RohanMuthyala47/FPGA_Image_Haze_Removal/Vivado/RTL/sim/building_512.bmp

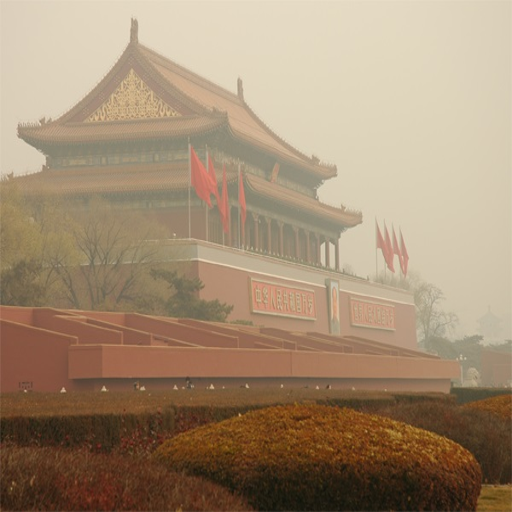
Vivado/RTL/sim/building_512.bmp
