RohanMuthyala47/FPGA_Image_Haze_Removal/Vivado/RTL/sim/road_512.bmp

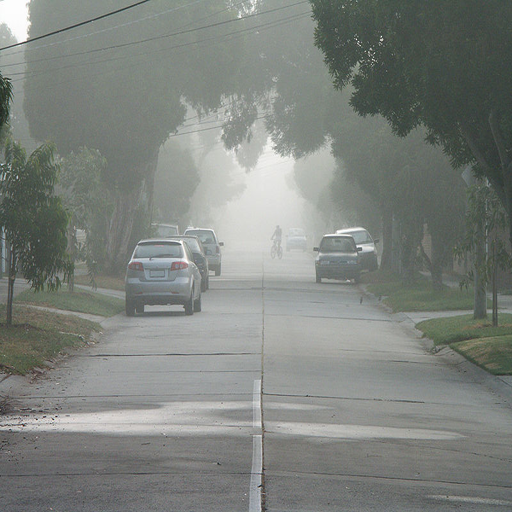
Vivado/RTL/sim/road_512.bmp
