RohanMuthyala47/FPGA_Image_Haze_Removal/Vivado/RTL/sim/town_512.bmp

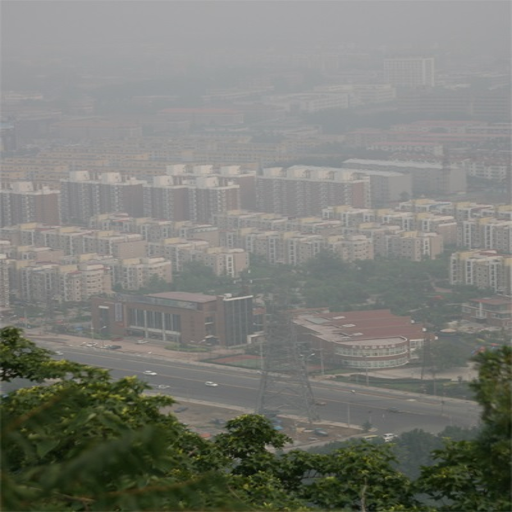
Vivado/RTL/sim/town_512.bmp
