RohanMuthyala47/FPGA_Image_Haze_Removal/Vivado/RTL/sources/TE_and_SRSC.v

// Transmission Estimation, Scene Recovery and Saturation Correction Module
`define Image_Size (512 * 512)
module TE_and_SRSC (
    input        clk,
    
    input        input_valid,                                 // Input data valid signal
    input [23:0] input_pixel_1, input_pixel_2, input_pixel_3,
                 input_pixel_4, input_pixel_5, input_pixel_6,
                 input_pixel_7, input_pixel_8, input_pixel_9, // 3x3 window input
    
    input [7:0]  A_R, A_G, A_B,                               // Atmospheric Light Values
    input [9:0]  Inv_AR, Inv_AG, Inv_AB,                      // Inverse Atmospheric Light Values(Q0.10)

    output [7:0] J_R, J_G, J_B,                               // Output corrected pixels
    output       output_valid                                 // Output data valid signal
);

    // Pipeline the Center Pixel for SRSC
    reg [23:0] I_P, I_P1, I_P2, I_P3, I_P4;
    
    // Pipeline Atmospheric Light values for SRSC
    reg [7:0]  A_R_P, A_G_P, A_B_P;
    reg [7:0]  A_R_P1, A_G_P1, A_B_P1;
    reg [7:0]  A_R_P2, A_G_P2, A_B_P2;
    reg [7:0]  A_R_P3, A_G_P3, A_B_P3;
    reg [7:0]  A_R_P4, A_G_P4, A_B_P4;
    
    //==================================================================================
    // STAGE 4 LOGIC
    //==================================================================================
    
    // Detect the type of edge in the 3x3 window
    wire       corner_pixels_weight, edge_pixels_weight, center_pixel_weight;
    
    // Pipeline Registers
    reg        corner_pixels_weight_P, edge_pixels_weight_P, center_pixel_weight_P;
    
    reg [9:0]  Inv_AR_P, Inv_AG_P, Inv_AB_P;
    
    reg [23:0] I1_P, I2_P, I3_P,
               I4_P, I5_P, I6_P,
               I7_P, I8_P, I9_P;
               
    reg        stage_4_valid;
    
    //===========================================
    // Detect the type of edge in the 3x3 window
    FilterWeights_Estimation_Top Estimate_FilterWeights (
        .input_pixel_1(input_pixel_1), .input_pixel_2(input_pixel_2), .input_pixel_3(input_pixel_3),
        .input_pixel_4(input_pixel_4),                                .input_pixel_6(input_pixel_6), 
        .input_pixel_7(input_pixel_7), .input_pixel_8(input_pixel_8), .input_pixel_9(input_pixel_9),
        
        .corner_pixels_weight(corner_pixels_weight),
        .edge_pixels_weight(edge_pixels_weight),
        .center_pixel_weight(center_pixel_weight)
    );
    //===========================================
    
    // Update Stage 4 Pipeline Registers
    always @(posedge clk) begin
        corner_pixels_weight_P <= corner_pixels_weight;
        edge_pixels_weight_P   <= edge_pixels_weight;
        center_pixel_weight_P  <= center_pixel_weight;
        
        I1_P <= input_pixel_1; I2_P <= input_pixel_2; I3_P <= input_pixel_3;
        I4_P <= input_pixel_4; I5_P <= input_pixel_5; I6_P <= input_pixel_6;
        I7_P <= input_pixel_7; I8_P <= input_pixel_8; I9_P <= input_pixel_9;
                    
        Inv_AR_P <= Inv_AR; Inv_AG_P <= Inv_AG; Inv_AB_P <= Inv_AB;

        I_P <= input_pixel_5;
        
        A_R_P <= A_R;
        A_G_P <= A_G;
        A_B_P <= A_B;
                    
        stage_4_valid <= input_valid;
    end
    
    //==================================================================================
    // STAGE 5 LOGIC
    //==================================================================================
    
    wire [7:0] filtered_pixel_red, filtered_pixel_green, filtered_pixel_blue;
    
    // Pipeline Registers
    reg [9:0]  Inv_AR_P1, Inv_AG_P1, Inv_AB_P1;
    
    reg [7:0]  filtered_pixel_red_P, filtered_pixel_green_P, filtered_pixel_blue_P;
    
    reg        stage_5_valid;
    
    //===========================================
    // Filter blocks to apply Gaussian Filter or Mean Filter based on the edge detected
    WindowFilter Red_WindowFilter (
        .w_corner(corner_pixels_weight_P),
        .w_edge(edge_pixels_weight_P),
        .w_center(center_pixel_weight_P),
    
        .input_pixel_1(I1_P[23:16]), .input_pixel_2(I2_P[23:16]), .input_pixel_3(I3_P[23:16]),
        .input_pixel_4(I4_P[23:16]), .input_pixel_5(I5_P[23:16]), .input_pixel_6(I6_P[23:16]),
        .input_pixel_7(I7_P[23:16]), .input_pixel_8(I8_P[23:16]), .input_pixel_9(I9_P[23:16]),
        
        .filtered_pixel(filtered_pixel_red)
    );
                   
    WindowFilter Green_WindowFilter (
        .w_corner(corner_pixels_weight_P),
        .w_edge(edge_pixels_weight_P),
        .w_center(center_pixel_weight_P),

        .input_pixel_1(I1_P[15:8]), .input_pixel_2(I2_P[15:8]), .input_pixel_3(I3_P[15:8]),
        .input_pixel_4(I4_P[15:8]), .input_pixel_5(I5_P[15:8]), .input_pixel_6(I6_P[15:8]),
        .input_pixel_7(I7_P[15:8]), .input_pixel_8(I8_P[15:8]), .input_pixel_9(I9_P[15:8]),
        
        .filtered_pixel(filtered_pixel_green)
    );
                   
    WindowFilter Blue_WindowFilter (
        .w_corner(corner_pixels_weight_P),
        .w_edge(edge_pixels_weight_P),
        .w_center(center_pixel_weight_P),

        .input_pixel_1(I1_P[7:0]), .input_pixel_2(I2_P[7:0]), .input_pixel_3(I3_P[7:0]),
        .input_pixel_4(I4_P[7:0]), .input_pixel_5(I5_P[7:0]), .input_pixel_6(I6_P[7:0]),
        .input_pixel_7(I7_P[7:0]), .input_pixel_8(I8_P[7:0]), .input_pixel_9(I9_P[7:0]),
                       
        .filtered_pixel(filtered_pixel_blue)
    );
    //===========================================
    
    // Update Stage 5 Pipeline Registers 
    always @(posedge clk) begin
        Inv_AR_P1 <= Inv_AR_P;
        Inv_AG_P1 <= Inv_AG_P;
        Inv_AB_P1 <= Inv_AB_P;
            
        filtered_pixel_red_P   <= filtered_pixel_red;
        filtered_pixel_green_P <= filtered_pixel_green;
        filtered_pixel_blue_P  <= filtered_pixel_blue;
                                
        I_P1 <= I_P;
                                
        A_R_P1 <= A_R_P;
        A_G_P1 <= A_G_P; 
        A_B_P1 <= A_B_P;
                                
        stage_5_valid <= stage_4_valid;
    end
    
    //==========================================================================
    // STAGE 6 LOGIC
    //==========================================================================
    
    // Select signal for minimum filter result
    wire [1:0] min_val_sel;
    
    wire [7:0] min_Fc;
    
    wire [9:0] min_Ac;
        
    wire [9:0] product;
        
    // (Ic - Ac) Result
    wire [7:0] IR_minus_AR, IG_minus_AG, IB_minus_AB;
    wire       add_or_sub_R, add_or_sub_G, add_or_sub_B;
    
    wire [7:0] I_R = I_P1[23:16], I_G = I_P1[15:8], I_B = I_P1[7:0];
        
    // Pipeline Registers for stage 6
    reg  [7:0] IR_minus_AR_P, IG_minus_AG_P, IB_minus_AB_P;
    reg        add_or_sub_R_P, add_or_sub_G_P, add_or_sub_B_P;
    
    reg        stage_6_valid;
    
    //===========================================
    // Comparator to determine the minimum value of the filter results
    Comparator_Minimum Minimum_Filter_Select (
        .red(filtered_pixel_red_P), .green(filtered_pixel_green_P), .blue(filtered_pixel_blue_P),
        
        .min_val_sel(min_val_sel)
    );
    
    // Multiplexer to choose minimum of the filter results
    Fc_Multiplexer Minimum_Filtered_Pixel_Value (
        .F_R(filtered_pixel_red_P), .F_G(filtered_pixel_green_P), .F_B(filtered_pixel_blue_P),
        
        .sel(min_val_sel),
        
        .Fc(min_Fc)
    );
    
    // Multiplexer to choose minimum of Atmospheric Light values
    Inv_Ac_Multiplexer Minimum_Inv_ALE_Value (
        .Inv_AR(Inv_AR_P1), .Inv_AG(Inv_AG_P1), .Inv_AB(Inv_AB_P1),
        
        .sel(min_val_sel),
        
        .Inv_Ac(min_Ac)
    );
    
    // Multiplier modules to compute Fc * Ac (Scaled)
    Multiplier_TE Multiplier_TE (
        .clk(clk),
        
        .Fc(min_Fc), .Inv_Ac(min_Ac),
        
        .product(product)
    );
    
    // SUBTRACTOR MODULES TO COMPUTE (|Ic - Ac|)
    Subtractor_SRSC Sub_Red (
        .Ic(I_R),
        .Ac(A_R_P1),
            
        .Ic_minus_Ac(IR_minus_AR),
            
        .add_or_sub(add_or_sub_R)
    );
                    
    Subtractor_SRSC Sub_Green (
        .Ic(I_G),
        .Ac(A_G_P1),
            
        .Ic_minus_Ac(IG_minus_AG),
            
        .add_or_sub(add_or_sub_G)
    );
                
    Subtractor_SRSC Sub_Blue (
        .Ic(I_B),
        .Ac(A_B_P1),
            
        .Ic_minus_Ac(IB_minus_AB),
            
        .add_or_sub(add_or_sub_B)
    );
    //===========================================
    
    // Update Stage 6 Pipeline Registers
    always @(posedge clk) begin
        I_P2 <= I_P1;
            
        A_R_P2 <= A_R_P1;
        A_G_P2 <= A_G_P1;
        A_B_P2 <= A_B_P1;
                        
        IR_minus_AR_P <= IR_minus_AR;
        IG_minus_AG_P <= IG_minus_AG;
        IB_minus_AB_P <= IB_minus_AB;
                       
        add_or_sub_R_P <= add_or_sub_R;
        add_or_sub_G_P <= add_or_sub_G;
        add_or_sub_B_P <= add_or_sub_B;
            
        stage_6_valid <= stage_5_valid;
    end
    
    //==========================================================================
    // STAGE 7 LOGIC
    //==========================================================================
    
    wire [7:0] transmission_reciprocal;
    
    // (|Ic-Ac|)*(1/T) Result
    wire [7:0] IR_minus_AR_x_T, IG_minus_AG_x_T, IB_minus_AB_x_T;
    
    // Pipeline Registers for stage 7
    reg        add_or_sub_R_P1, add_or_sub_G_P1, add_or_sub_B_P1;
    
    reg        stage_7_valid;
    
    //===========================================
    // TRANSMISSION RECIPROCAL LOOKUP TABLE
    Transmission_Reciprocal_LUT Transmission_Reciprocal_LUT (
        .in(product),
                            
        .out(transmission_reciprocal)
    );
                    
    // MULTIPLIER MODULES TO COMPUTE (|Ic-Ac|)*(1/T)
    Multiplier_SRSC Multiplier_SRSC_Red (
        .clk(clk), 
            
        .Inv_Trans(transmission_reciprocal), 
        .Ic_minus_Ac(IR_minus_AR_P), 
            
        .product(IR_minus_AR_x_T) 
    );
                            
    Multiplier_SRSC Multiplier_SRSC_Green (
        .clk(clk), 
             
        .Inv_Trans(transmission_reciprocal), 
        .Ic_minus_Ac(IG_minus_AG_P), 
            
        .product(IG_minus_AG_x_T) 
    ); 
                        
    Multiplier_SRSC Multiplier_SRSC_Blue (
        .clk(clk), 
            
        .Inv_Trans(transmission_reciprocal), 
        .Ic_minus_Ac(IB_minus_AB_P), 
            
        .product(IB_minus_AB_x_T) 
    );
    //===========================================
        
    // Update stage 7 pipeline registers
    always @(posedge clk) begin
        I_P3 <= I_P2;
      
        A_R_P3 <= A_R_P2;
        A_G_P3 <= A_G_P2;
        A_B_P3 <= A_B_P2;

        add_or_sub_R_P1 <= add_or_sub_R_P;
        add_or_sub_G_P1 <= add_or_sub_G_P;
        add_or_sub_B_P1 <= add_or_sub_B_P;
            
        stage_7_valid <= stage_6_valid;
    end

    //==========================================================================
    // STAGE 8 LOGIC
    //==========================================================================
    
    // Pipeline Registers for stage 8
    reg       add_or_sub_R_P2, add_or_sub_G_P2, add_or_sub_B_P2;
    
    reg       stage_8_valid;
        
    // Update stage 8 pipeline registers
    always @(posedge clk) begin
        A_R_P4 <= A_R_P3;
        A_G_P4 <= A_G_P3;
        A_B_P4 <= A_B_P3;
        
        I_P4 <= I_P3;
        
        add_or_sub_R_P2 <= add_or_sub_R_P1;
        add_or_sub_G_P2 <= add_or_sub_G_P1;
        add_or_sub_B_P2 <= add_or_sub_B_P1;
                
        stage_8_valid <= stage_7_valid;
    end
        
    //==========================================================================
    // STAGE 9 LOGIC
    //==========================================================================
        
    // Compute Ac +/- (|Ic-Ac|/T)
    wire [7:0] Sum_Red, Sum_Green, Sum_Blue;
        
    // Outputs of Look-Up Tables for Saturation Corection
    wire [9:0] J_R_Corrected, J_G_Corrected, J_B_Corrected;
    wire [9:0] A_R_Corrected, A_G_Corrected, A_B_Corrected;
    
    // Pipeline Registers for stage 9
    reg        stage_9_valid;
        
    //===========================================
    // ADDER BLOCKS TO COMPUTE Ac +/- (|Ic-Ac|/T)
    Adder_SRSC Add_Red (
        .Ac(A_R_P4), 
        .Ic(I_P4[23:16]), 
        .Multiplier_out(IR_minus_AR_x_T), 
             
        .add_or_sub(add_or_sub_R_P2), 
             
        .sum(Sum_Red) 
    );
                             
    Adder_SRSC Add_Green (
        .Ac(A_G_P4), 
        .Ic(I_P4[15:8]), 
        .Multiplier_out(IG_minus_AG_x_T), 
      
        .add_or_sub(add_or_sub_G_P2), 
             
        .sum(Sum_Green) 
    );
                             
    Adder_SRSC Add_Blue (
        .Ac(A_B_P4), 
        .Ic(I_P4[7:0]), 
        .Multiplier_out(IB_minus_AB_x_T), 
      
        .add_or_sub(add_or_sub_B_P2), 
              
        .sum(Sum_Blue) 
    );
        
    // LOOK-UP TABLES TO COMPUTE Ac ^ 0.3 AND Jc ^ 0.7
    LUT_03 A_R_Correction (
        .in(A_R_P4), 
        .out(A_R_Corrected) 
    );
        
    LUT_03 A_G_Correction (
        .in(A_G_P4), 
        .out(A_G_Corrected) 
    );
        
    LUT_03 A_B_Correction (
        .in(A_B_P4), 
        .out(A_B_Corrected) 
    ); 
    
    LUT_07 J_R_Correction (
        .in(Sum_Red), 
        .out(J_R_Corrected) 
    );
        
    LUT_07 J_G_Correction (
        .in(Sum_Green), 
        .out(J_G_Corrected) 
    );
        
    LUT_07 J_B_Correction (
        .in(Sum_Blue), 
        .out(J_B_Corrected) 
    );
    
    // MULTIPLIER MODULES TO COMPUTE Ac^0.3 * Jc^0.7
    Saturation_Correction_Multiplier Saturation_Correction_Red (
        .clk(clk), 
      
        .Ac(A_R_Corrected), .Jc(J_R_Corrected), 
      
        .Corrected_Pixel(J_R) 
    );
    
    Saturation_Correction_Multiplier Saturation_Correction_Green (
        .clk(clk), 
            
        .Ac(A_G_Corrected), .Jc(J_G_Corrected), 
            
        .Corrected_Pixel(J_G) 
    );
    
    Saturation_Correction_Multiplier Saturation_Correction_Blue (
        .clk(clk), 
    
        .Ac(A_B_Corrected), .Jc(J_B_Corrected), 
            
        .Corrected_Pixel(J_B) 
    );
    //===========================================
        
    // Update stage 9 pipeline registers
    always @(posedge clk) begin
        stage_9_valid <= stage_8_valid; 
    end
    
    assign output_valid = stage_9_valid; 

endmodule
