RohanMuthyala47/FPGA_Image_Haze_Removal/Vivado/RTL/sources/ALE_Instantiations/Atmospheric_Light_Reciprocal_LUT.v

module Atmospheric_Light_Reciprocal_LUT (
    input  [7:0] in,
    output reg [9:0] out
);

    always @(*) begin
        casez (in)
            8'd  1: out = 10'd 960;  // 0.9375/1 ≈ 0.93750000
            8'd  2: out = 10'd 480;  // 0.9375/2 ≈ 0.46875000
            8'd  3: out = 10'd 320;  // 0.9375/3 ≈ 0.31250000
            8'd  4: out = 10'd 240;  // 0.9375/4 ≈ 0.23437500
            8'd  5: out = 10'd 192;  // 0.9375/5 ≈ 0.18750000
            8'd  6: out = 10'd 160;  // 0.9375/6 ≈ 0.15625000
            8'd  7: out = 10'd 137;  // 0.9375/7 ≈ 0.13392857
            8'd  8: out = 10'd 120;  // 0.9375/8 ≈ 0.11718750
            8'd  9: out = 10'd 107;  // 0.9375/9 ≈ 0.10416667
            8'd 10: out = 10'd  96;  // 0.9375/10 ≈ 0.09375000
            8'd 11: out = 10'd  87;  // 0.9375/11 ≈ 0.08522727
            8'd 12: out = 10'd  80;  // 0.9375/12 ≈ 0.07812500
            8'd 13: out = 10'd  74;  // 0.9375/13 ≈ 0.07211538
            8'd 14: out = 10'd  69;  // 0.9375/14 ≈ 0.06696429
            8'd 15: out = 10'd  64;  // 0.9375/15 ≈ 0.06250000
            8'd 16: out = 10'd  60;  // 0.9375/16 ≈ 0.05859375
            8'd 17: out = 10'd  56;  // 0.9375/17 ≈ 0.05514706
            8'd 18: out = 10'd  53;  // 0.9375/18 ≈ 0.05208333
            8'd 19: out = 10'd  51;  // 0.9375/19 ≈ 0.04934211
            8'd 20: out = 10'd  48;  // 0.9375/20 ≈ 0.04687500
            8'd 21: out = 10'd  46;  // 0.9375/21 ≈ 0.04464286
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
            8'd253: out = 10'd   4;  // 0.9375/253 ≈ 0.00370553
            8'd254: out = 10'd   4;  // 0.9375/254 ≈ 0.00369094
            8'd255: out = 10'd   4;  // 0.9375/255 ≈ 0.00367647
            default: out = 10'd1023; // default case
        endcase
    end

endmodule
