RohanMuthyala47/FPGA_Image_Haze_Removal/Vivado/RTL/sources/SRSC_Instantiations/SaturationCorrection_LUT.v

// LUT for x^0.3 in Q3.7 format
module LUT_03 (
    input      [7:0] in, // Q8.0 input
    output reg [9:0] out // Q3.7 output
);

    always @(*) begin
        casez (in)
            8'd0  : out = 10'd0;  // 0^0.30 ~= 0.000000
            8'd1  : out = 10'd128;  // 1^0.30 ~= 1.000000
            8'd2  : out = 10'd158;  // 2^0.30 ~= 1.231144
            8'd3  : out = 10'd178;  // 3^0.30 ~= 1.390389
            8'd4  : out = 10'd194;  // 4^0.30 ~= 1.515717
            8'd5  : out = 10'd207;  // 5^0.30 ~= 1.620657
            8'd6  : out = 10'd219;  // 6^0.30 ~= 1.711770
            8'd7  : out = 10'd229;  // 7^0.30 ~= 1.792790
            8'd8  : out = 10'd239;  // 8^0.30 ~= 1.866066
            8'd9  : out = 10'd247;  // 9^0.30 ~= 1.933182
            8'd10 : out = 10'd255;  // 10^0.30 ~= 1.995262
            8'd11 : out = 10'd263;  // 11^0.30 ~= 2.053136
            8'd12 : out = 10'd270;  // 12^0.30 ~= 2.107436
            8'd13 : out = 10'd276;  // 13^0.30 ~= 2.158654
            8'd14 : out = 10'd283;  // 14^0.30 ~= 2.207183
            8'd15 : out = 10'd288;  // 15^0.30 ~= 2.253343
            8'd16 : out = 10'd294;  // 16^0.30 ~= 2.297397
            8'd17 : out = 10'd299;  // 17^0.30 ~= 2.339563
            8'd18 : out = 10'd305;  // 18^0.30 ~= 2.380026
            8'd19 : out = 10'd310;  // 19^0.30 ~= 2.418945
            8'd20 : out = 10'd314;  // 20^0.30 ~= 2.456456
            8'd21 : out = 10'd319;  // 21^0.30 ~= 2.492676
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
            8'd253: out = 10'd770;  // 253^0.70 ~= 48.104352
            8'd254: out = 10'd772;  // 254^0.70 ~= 48.237368
            8'd255: out = 10'd774;  // 255^0.70 ~= 48.370227
            default: out = 10'd0;
        endcase
    end
endmodule
