RohanMuthyala47/FPGA_Image_Haze_Removal/Vivado/RTL/sources/SRSC_Instantiations/Transmission_Reciprocal_LUT.v

module Transmission_Reciprocal_LUT (
    input  [9:0] in,      // Q0.10 transmission value (ranges from 0 to 0.65)
    output reg [7:0] out  // Q2.6 reciprocal
);

    always @(*) begin 
        casez (in) 
            10'd   0: out = 8'h40; 
            10'd   1: out = 8'h40;
            10'd   2: out = 8'h40;
            10'd   3: out = 8'h40;
            10'd   4: out = 8'h40;
            10'd   5: out = 8'h40;
            10'd   6: out = 8'h40;
            10'd   7: out = 8'h40;
            10'd   8: out = 8'h41;
            10'd   9: out = 8'h41;
            10'd  10: out = 8'h41;
            10'd  11: out = 8'h41;
            10'd  12: out = 8'h41;
            10'd  13: out = 8'h41;
            10'd  14: out = 8'h41;
            10'd  15: out = 8'h41;
            10'd  16: out = 8'h41;
            10'd  17: out = 8'h41;
            10'd  18: out = 8'h41;
            10'd  19: out = 8'h41;
            10'd  20: out = 8'h41;
            10'd  21: out = 8'h41;
            10'd  22: out = 8'h41;
            10'd  23: out = 8'h41;
            10'd  24: out = 8'h42;
            10'd  25: out = 8'h42;
            10'd  26: out = 8'h42;
            10'd  27: out = 8'h42;
            10'd  28: out = 8'h42;
            10'd  29: out = 8'h42;
            10'd  30: out = 8'h42;
            10'd  31: out = 8'h42;
            10'd  32: out = 8'h42;
            10'd  33: out = 8'h42;
            10'd  34: out = 8'h42;
            10'd  35: out = 8'h42;
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
            10'd 661: out = 8'hB5;
            10'd 662: out = 8'hB5;
            10'd 663: out = 8'hB6;
            10'd 664: out = 8'hB6;
            10'd 665: out = 8'hB7;
            10'd 666: out = 8'hB7;
            default:  out = 8'hB8;
        endcase
    end
endmodule
