RohanMuthyala47/FPGA_Image_Haze_Removal/Vivado/RTL/sources/TE_Instantiations/Comparator_Minimum.v

// Comparator module which outputs the minimum value of the inputs
module Comparator_Minimum (
    input  [7:0] red, green, blue,
    output [1:0] min_val_sel
);
    
    localparam RED = 2'b00, GREEN = 2'b01, BLUE = 2'b10;
    
    assign min_val_sel = (red <= green && red <= blue)   ? RED : 
                         (green <= red && green <= blue) ? GREEN : 
                                                           BLUE;

endmodule
