RohanMuthyala47/FPGA_Image_Haze_Removal/Vivado/Verilog/sources/TE_Instantiations/Stage_7_Mux.v

// Stage 7 multiplexer to choose the pre-transmission value based on edge detected
module Pre_Transmission_Mux (
    input  [13:0] a, b, c,
    input  [1:0]  sel,
        
    output [13:0] out
);
    
    assign out = (sel == 2'b00) ? a : 
                 (sel == 2'b01) ? b : 
                 (sel == 2'b10) ? c :
                 13'b0;
    
endmodule
