RohanMuthyala47/FPGA_Image_Haze_Removal/Verilog/srcs/TE_Instantiations/Mux_16bit.v

// Stage 7 multiplexer
module mux_16bit(
    input [15:0] a, b, c,
    input [1:0]  sel,
        
    output [15:0] out
);
    
    assign out = (sel == 2'b00) ? a : 
                 (sel == 2'b01) ? b : 
                 (sel == 2'b10) ? c :
                  0;
    
endmodule
