RohanMuthyala47/FPGA_Image_Haze_Removal/(commit log)

2025-07-15 Update and rename Mux_16bit.v to Stage_7_Mux.v
2025-08-31 Update and rename Stage_7_Mux.v to Pre_Transmission_Mux.v
